PTIT-Open-Source/He-thong-do-muc-do-tieng-on---Nhom-4/docs/Schematic_Lora.pdf

## MAX9814 MIC

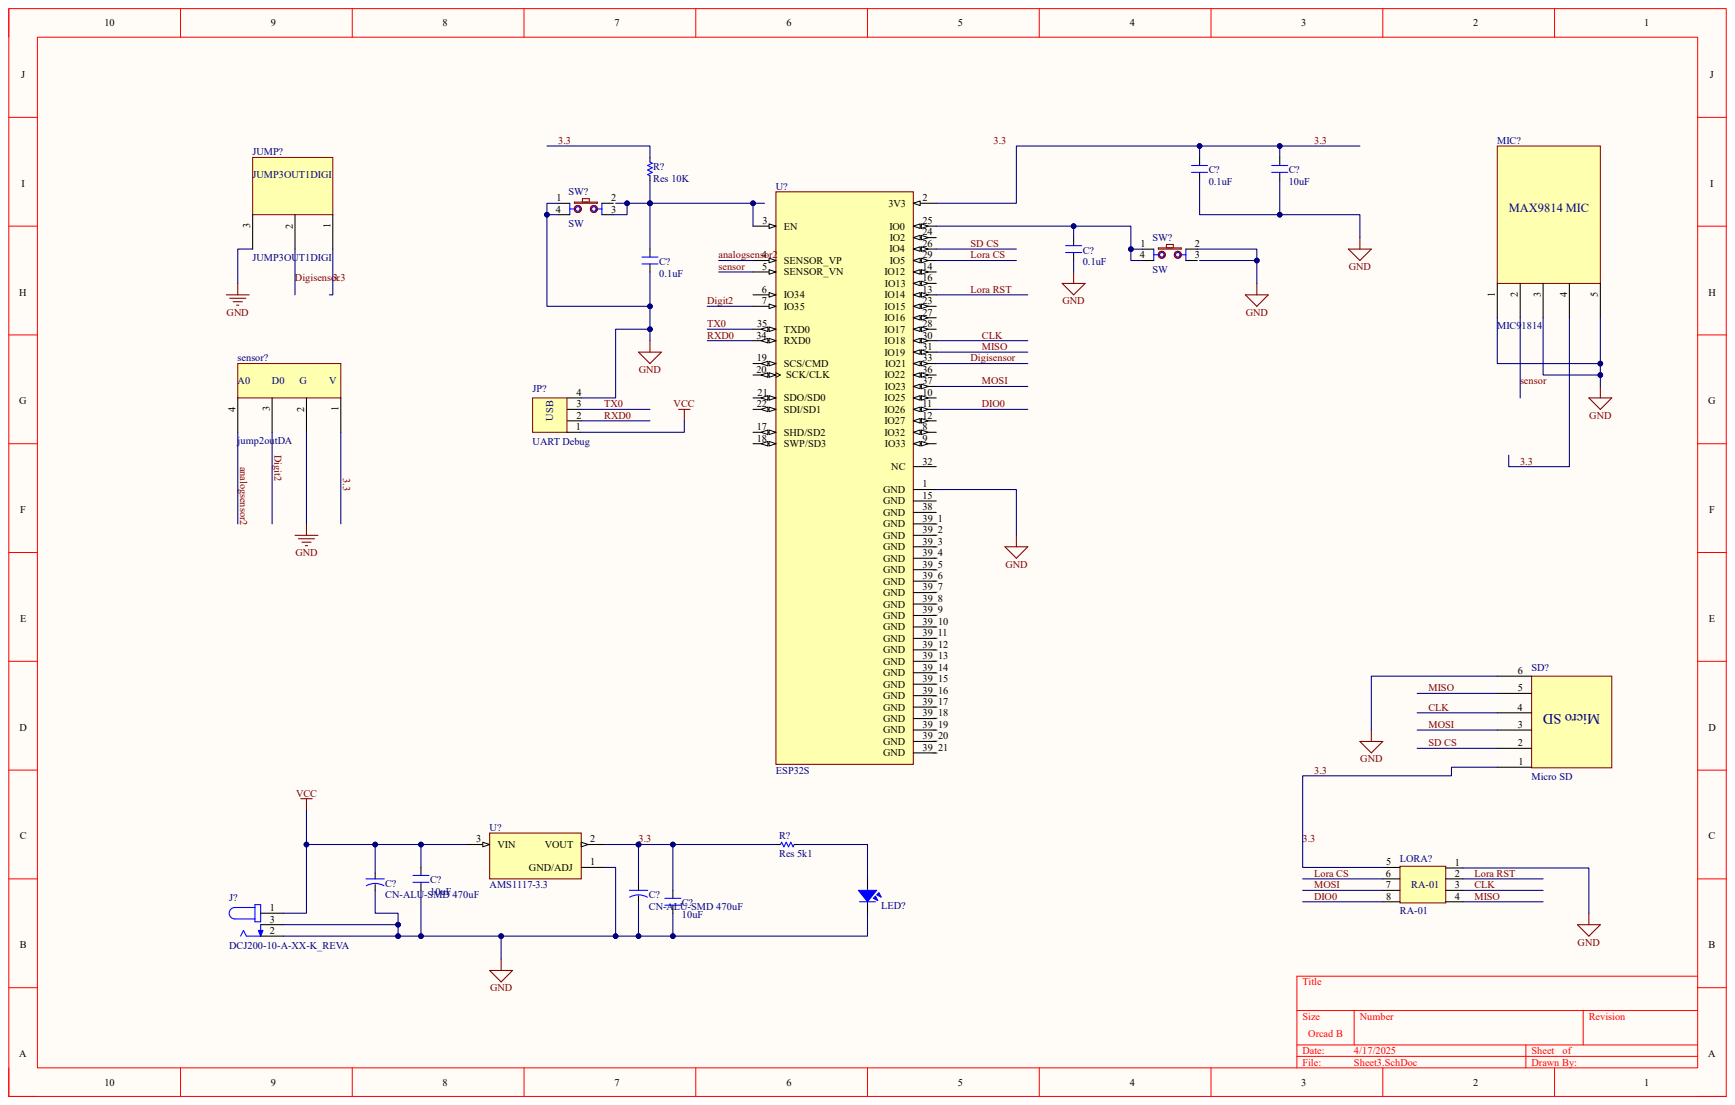
[picture p5: page 1]
Title; Size; Number; Revision; Orcad B; Date:; Sheet of; File:; Sheet3.SchDoc; Drawn By:; R? Res 10K; SENSOR_VP; SENSOR_VN; TXD0 35 RXD0 34; SCS/CMD 19 SCK/CLK 20; SDO/SD0 21 SDI/SD1 22; SHD/SD2 17 SWP/SD3 18; GND; ESP32S; VIN; 3 VOUT; GND/ADJ; AMS1117-3.3 C? 10uF; Res 5k1; LED?; LORA?; 123456 Micro SD; Micro SD; 3.3 3.3 1324 USB; UART Debug; MIC?; MIC91814; sensor; DCJ200-10-A-XX-K_REVA; TX0 RXD0; VCC; CLK MISO; MOSI; DIO0; Lora RST; Lora CS; MISO; CLK; Lora CS MOSI DIO0; Lora RST CLK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

CN-ALU-SMD 470uF
